KyleStalker17/RcCar_Project/README.md

This is the arduino code, documentation, and STL files for a 1/24 scale replica of my 2004 Mini Cooper.
