KyleStalker17/RcCar_Project/STL files for printing/Shell/Wheels.stl

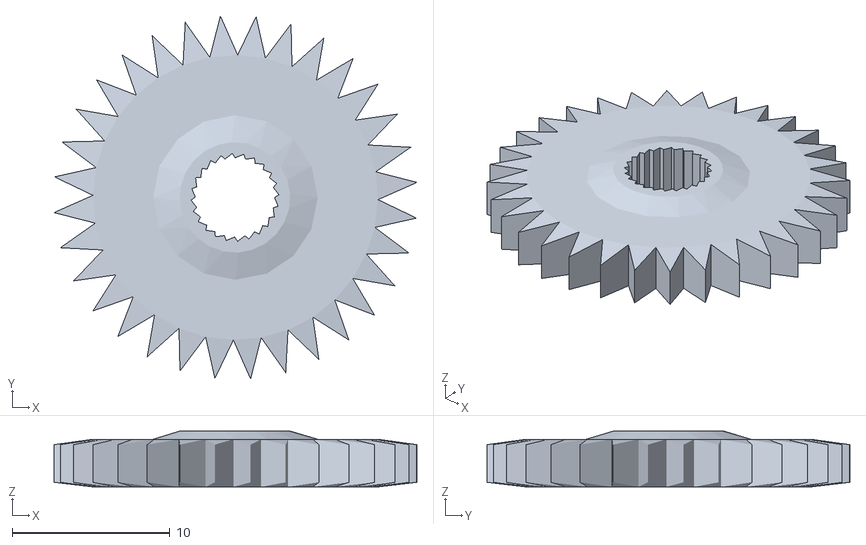
[picture p11: CAD file, 2025-03-11]
STL files for printing/Shell/Wheels.stl
23.0 x 23.0 x 3.54
