KyleStalker17/RcCar_Project/STL files for printing/Pedal/Bearing_holder.stl

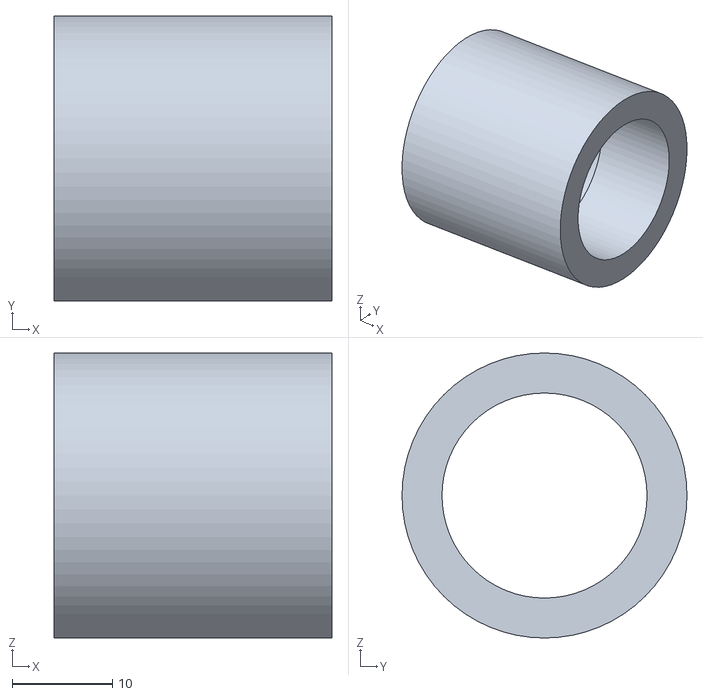
[picture p12: CAD file, 2024-04-04]
STL files for printing/Pedal/Bearing_holder.stl
27.7 x 28.4 x 28.4
