KyleStalker17/RcCar_Project/STL files for printing/Shell/MiniCooper_Motor_gear.stl

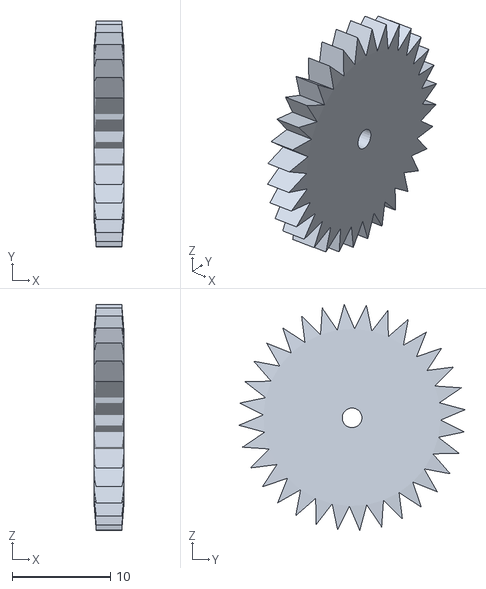
[picture p13: CAD file, 2025-03-11]
STL files for printing/Shell/MiniCooper_Motor_gear.stl
3.02 x 23.0 x 23.0
