KyleStalker17/RcCar_Project/STL files for printing/Pedal/Bearing_pot.stl

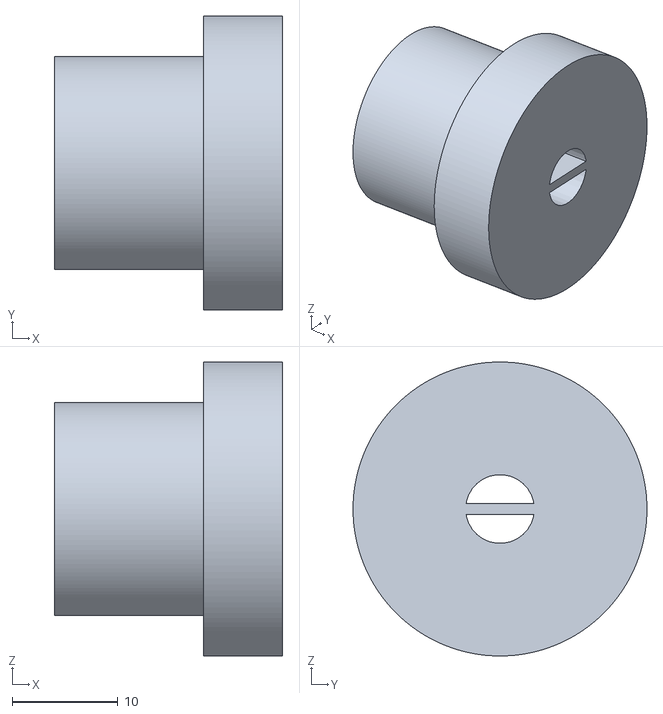
[picture p14: CAD file, 2024-04-04]
STL files for printing/Pedal/Bearing_pot.stl
21.6 x 27.8 x 27.8
