KyleStalker17/RcCar_Project/STL files for printing/Shell/MiniCooper_Bottom.stl

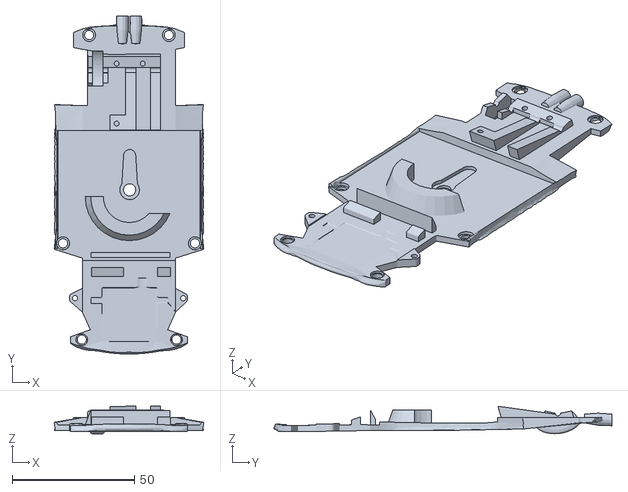
[picture p15: CAD file, 2025-03-11]
STL files for printing/Shell/MiniCooper_Bottom.stl
61.2 x 138.2 x 11.3
