KyleStalker17/RcCar_Project/STL files for printing/Pedal/Pedal_left.stl

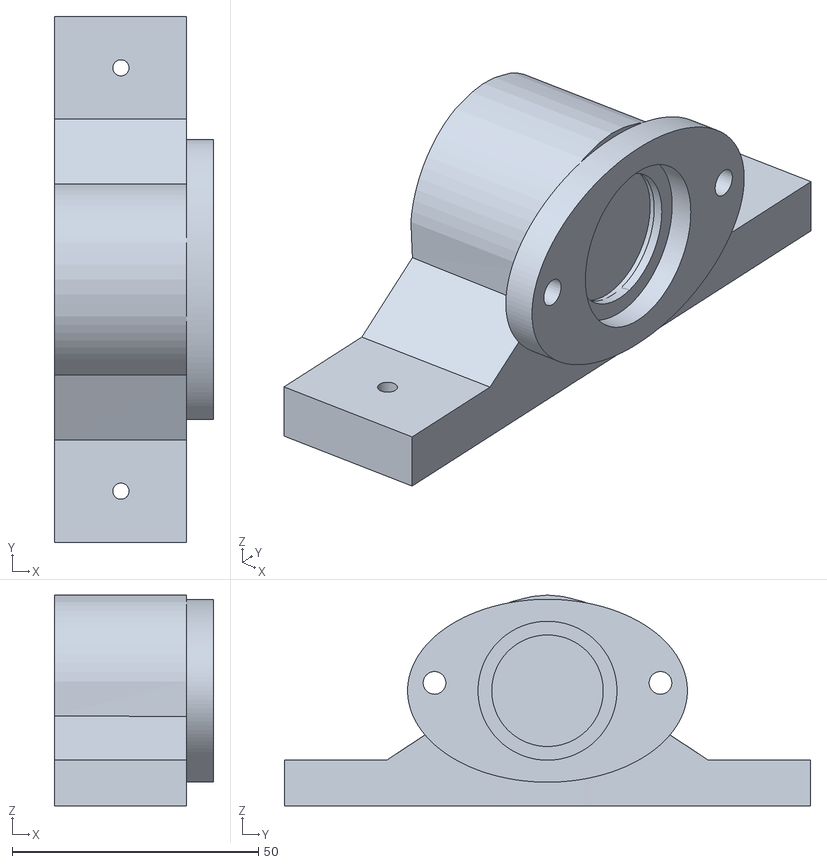
[picture p16: CAD file, 2024-04-04]
STL files for printing/Pedal/Pedal_left.stl
32.4 x 106.8 x 42.8
