KyleStalker17/RcCar_Project/STL files for printing/Pedal/Bearing.stl

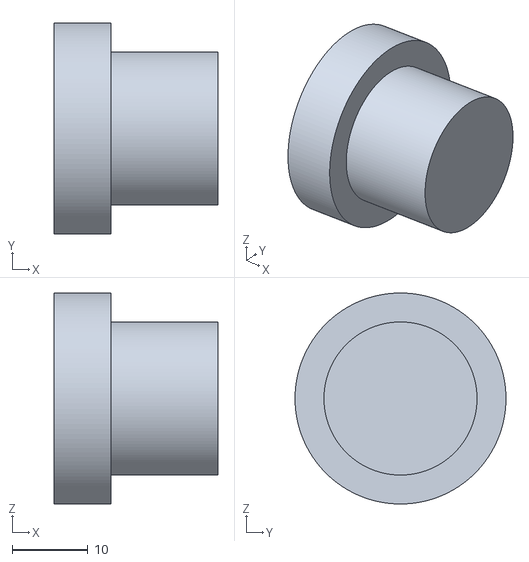
[picture p17: CAD file, 2024-04-04]
STL files for printing/Pedal/Bearing.stl
21.6 x 27.8 x 27.8
