KyleStalker17/RcCar_Project/STL files for printing/Shell/MiniCooper_Internal.stl

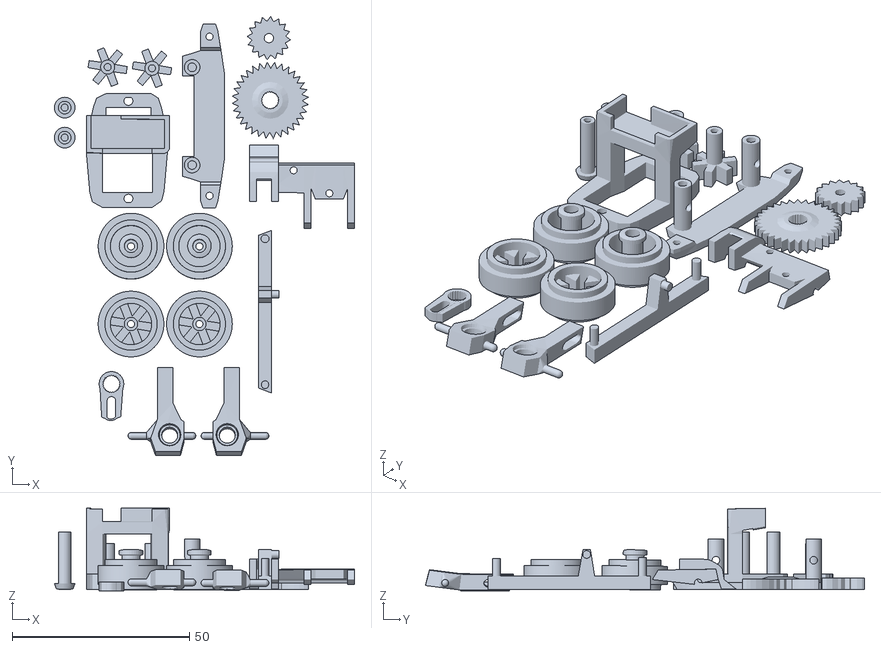
[picture p18: CAD file, 2025-03-11]
STL files for printing/Shell/MiniCooper_Internal.stl
84.7 x 123.8 x 23.3
