KyleStalker17/RcCar_Project/STL files for printing/Pedal/Pedal_slide_holder.stl

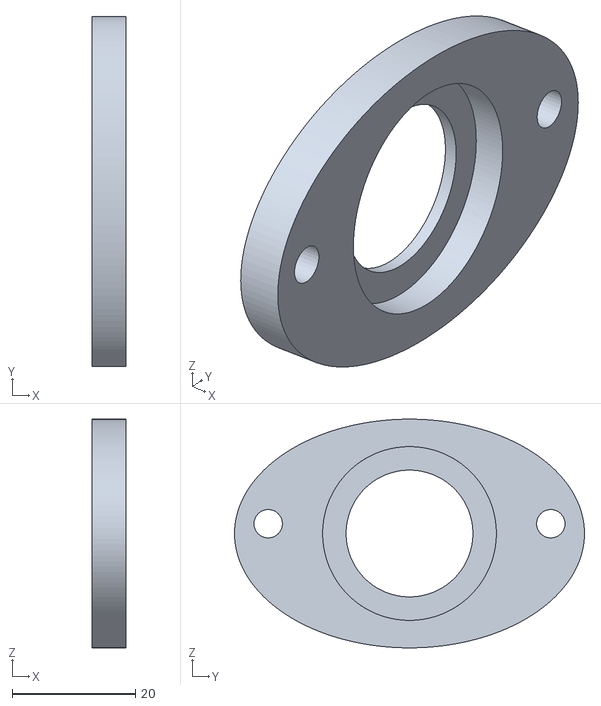
[picture p19: CAD file, 2024-04-04]
STL files for printing/Pedal/Pedal_slide_holder.stl
5.48 x 56.8 x 37.1
