KyleStalker17/RcCar_Project/STL files for printing/Shell/Internals_V3.stl

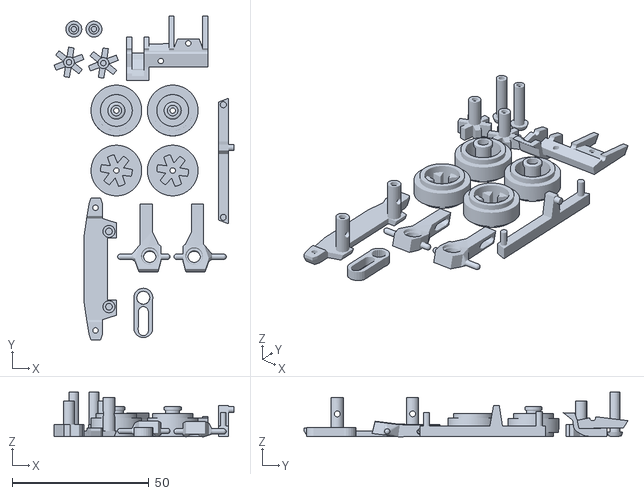
[picture p20: CAD file, 2025-03-11]
STL files for printing/Shell/Internals_V3.stl
65.8 x 118.5 x 16.3
