KyleStalker17/RcCar_Project/STL files for printing/Shell/MiniCooper_Motor_Holder.stl

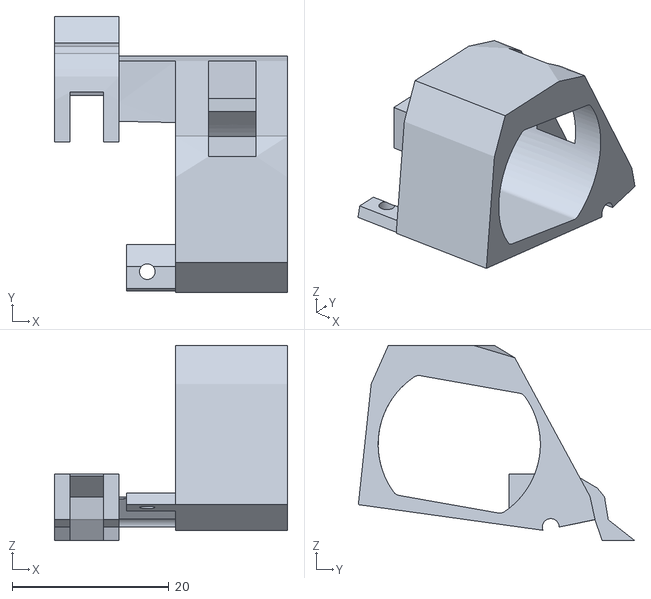
[picture p21: CAD file, 2025-03-11]
STL files for printing/Shell/MiniCooper_Motor_Holder.stl
29.7 x 35.2 x 24.9
