KyleStalker17/RcCar_Project/STL files for printing/Shell/MiniCooper_Roof.stl

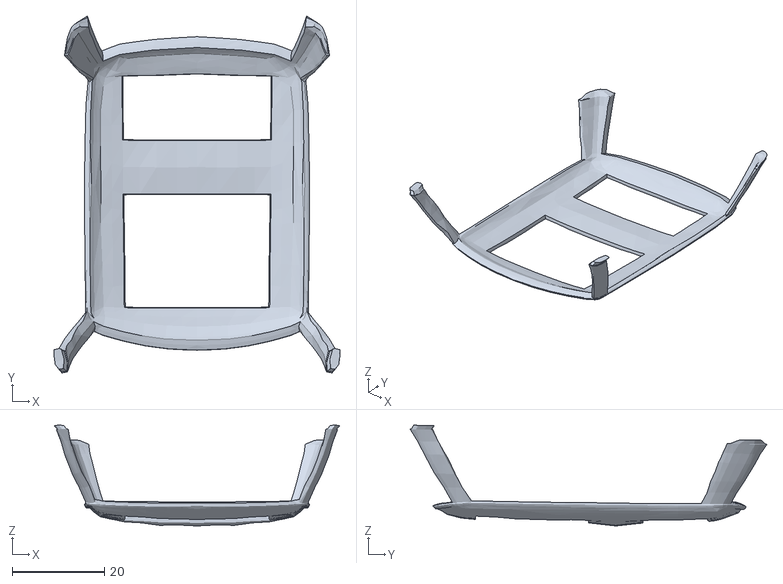
[picture p22: CAD file, 2024-04-04]
STL files for printing/Shell/MiniCooper_Roof.stl
61.9 x 77.3 x 21.8
