KyleStalker17/RcCar_Project/STL files for printing/Shell/MiniCooper.stl

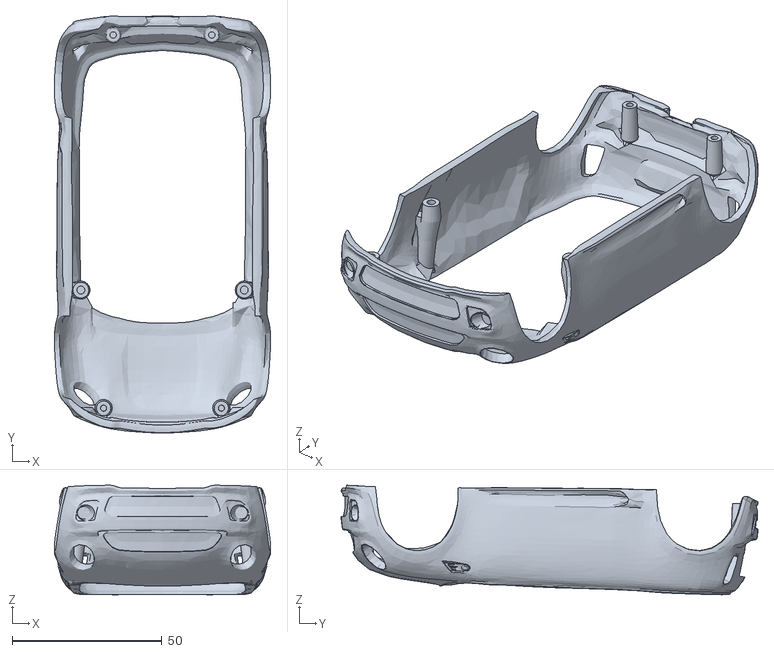
[picture p23: CAD file, 2024-04-02]
STL files for printing/Shell/MiniCooper.stl
72.2 x 139.2 x 36.6
