KyleStalker17/RcCar_Project/STL files for printing/Shell/Internals_V2.stl

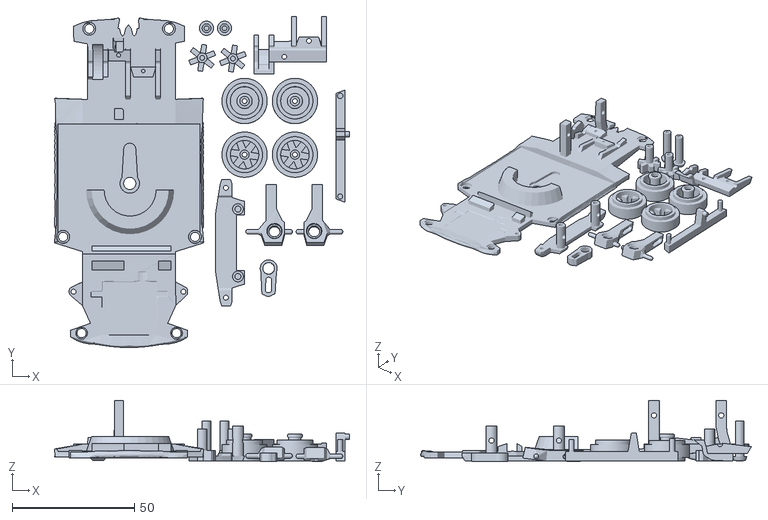
[picture p24: CAD file, 2025-03-11, an earlier design]
STL files for printing/Shell/Internals_V2.stl
120.8 x 135.4 x 25.1
