KyleStalker17/RcCar_Project/(commit log)

2024-04-02 Added .stl files
    [MiniCooper.stl]
2024-04-02 Added internal bits
    [MiniCooper_Bottom.stl, MiniCooper_Internal.stl]
2024-04-02 Final STL updates
    [MiniCooper.stl, MiniCooper_Bottom.stl, MiniCooper_Internal.stl]
2024-04-04 Added pedal files and added reverse gear
    [Bearing.stl, Bearing_holder.stl, Bearing_pot.stl, MiniCooper.stl, MiniCooper_Bottom.stl, MiniCooper_Internal.stl, MiniCooper_Roof.stl, Pedal.stl]
2024-04-04 Organized printing files and updated documentation
    [Bearing.stl, Bearing_holder.stl, Bearing_pot.stl, MiniCooper.stl, MiniCooper_Bottom.stl, MiniCooper_Internal.stl, MiniCooper_Roof.stl, Pedal.stl]
2024-04-10 Removed serial printing for finalizing
